Yaseen301/eruca-sync-smart-greenhouse/IMPORT-NOTES.md

# Imported implementation materials

Source: [Nadoooor/Eruca-Sync](https://github.com/Nadoooor/Eruca-Sync)

Pinned source revision: `49f52b0db70bf52fc38d7b9a41fe47a303049562`.

Original implementation author and copyright holder: Nader Sayed. The imported materials retain the upstream [MIT license](LICENSE) and [third-party asset credits](Docs/Credits.md).

## Scope

All 94 files from the pinned source revision are included. The upstream root README is preserved as [README-UPSTREAM.md](README-UPSTREAM.md), so the existing research overview remains the main README. Original relative paths are retained for the other source files, including archival documents and fabrication backups.

The import includes PlatformIO firmware source and configuration, compiled firmware binaries, editable STEP models, KiCad projects and footprints, fabrication outputs, bills of materials, build photos, and documentation.

Existing portfolio, poster, and extracted prototype illustrations are retained. Their authorship remains with the team credited in those documents; importing an MIT-licensed implementation does not by itself relicense those separate research materials.

## Verification and use

Imported file contents are checked against their upstream Git blob hashes. The imported source code and prebuilt binaries have not been modified, rebuilt, flashed, or tested on hardware during this import. The additional [firmware guide](Firmware/README.md) explains where the source, configuration, and prebuilt artifacts are located.
