Yaseen301/eruca-sync-smart-greenhouse/poster-fullsize.pdf

thermoelectric cooler, 1 water pump, and 6 LED sticks, to stabilize the system’s environmental parameters according to specific conditions and ranges.

Egypt faces major drawbacks that negatively affect its way to development. One of these drawbacks is climate change which refers to the vast changes in the average temperature per year. As a result, it impacts decreasing of the industrial and technological bases, leading to a deviation in Egyptian crop production. The purpose of this study is to solve the problem of the increasing threats of climate change to Siwa's crop production. To achieve that, a greenhouse project was chosen, depending on smart feedback loop system that uses temperature, soil moisture and light sensors in addition to actuators. Particularly, the structure is a gabled greenhouse where the plants must be planted and actuators are used. Moreover, the prototype had to meet some design requirements such as the parameter stabilizing time must be less than 30 min and the ability to operate within a time of at least 6 hours in addition to its ability to operate in equal time intervals for 5 consecutive days with a planting area of less than 0.25 m²
. The prototype was judged to be successful, and it met all design requirements as it took maximum 27.5 min to stabilize the parameters values, it was able to operate within 6 hours and in equal time intervals for 5 consecutive days. In addition, it had a planting area of 0.11 m²

Table X: Impact of temperature on crop yield (Moghazy & Kaluarachchi, 2021)

Egypt | faces | major | challenges | that | hinder | its
development and affects its individuals in several fields, involving industry, agriculture, and even its climate. Climate change is one of them that refers to the vast changes in the average temperature per year. Hence, it affected the industrial
and agricultural bases, naming it as another grand challenge.
Consequently, crop production of Egypt has diminished due to
heat stress and deviations in rainfall patterns that can negatively impact crop yields, particularly for heat-sensitive crops leafy greens (Abd El Maksoud, 2022). As shown in table 1, a small increase in temperature, like 2°C and 4°C, causes large hardy crops like maize losses 14.4% and 24.2% of their yield, respectively. Siwa Oasis is expected to lose its crop productivity due to heat changes. Using climate models, summer temperatures in Siwa are expected to rise by up to 4.65°C. Because of this heat, plants will need 18.2% more water just to stay alive, leading to crop failure (Moghazy & Kaluarachchi, 2021). As a result, the specific problem to be solved is the increasing threats of climate change to Siwa's crop production.
One of the prior solutions for such a problem is Thanet Earth, a massive commercial greenhouse complex conceived in the UK with a weak side of high initial investment. Nevertheless, one of its advantages is that it has vast pest and weather resistance. Another solution is El Bustan aquaponics farm, an aquaponic farm producing high quality plants, though having a weak heat control.
Hence, since the prior solutions had high initial cost and weak control, the selected solution is a low-cost gabled greenhouse with light, moisture and temperature control. Particularly, the prototype consists of a wooden gabled greenhouse structure with a maximum height of 0.45m and 0.55m, 0.45m for width and length respectively, to hold plant growth. Thereby, the structure is implemented to a smart closed loop system that associates all electric components with the ESP32 Microcontroller. Furthermore, temperature, soil moisture, light sensors and actuators were employed within the prototype to maintain the environmental conditions for plants to grow. Therefore, the project must meet some requirements to emphasize its successful working. They include its maximum time to stabilize a parameter reading that must not exceed 30 minutes. In addition, it must be able to operate within a time of at least 6 hours, as well as its ability to operate at equal time intervals for 5 consecutive days. Furthermore, the planting area must not exceed 0.25 m2. Finally, it is required to maintain the databases for two plants in the project. Several materials with different properties were used to meet the past requirements and achieve the success of the project, as shown in the next section.

Materials

Figure 14: Circuit’s schematic diagram

Feedback and automation system:
To achieve the best results, as shown in the results section, a feedback and automation system had to be made. As shown in Figure 14, the brain of the system that handles all the logic, sensor data processing, and control signals for the actuators is an ESP32-S3. It is connected to multiple sensors, which are a BH1750 digital light intensity sensor, an AM-2320 temperature sensor, and a capacitive analog soil moisture sensor V2.0, that sends environmental data via I2C or analog signals. Figure 15 shows the code that processes the data by converting the raw sensor outputs to the calibrated values according to the calibration equations using the ESP. After processing the data, the ESP sends orders to multiple connected actuators: 2 fans, 2 servo motors, 1

Table 2, Materials of the prototype

Figure 8: Attaching the servo motors Figure 9: Feedback system's circuit holders

Figure 6: Making the drainage holes

:Figure 7: Filling the planting area with soil mixture

Figure 5: Constructing the outer frame

Figure 4: Calibration Curve of the Temperature Sensor

Figure 3: Calibration Curve of Light Intensity Sensor

Figure 2: Calibration Curve of Soil Moisture Sensor

1-The greenhouse is constructed using recycled components for the main structure. As shown in Table 2, the materials are divided into structural components and the electronic feedback system components.
2-Before constructing, a 3D CAD model of the structure (Figure 1), and a circuit schematic was designed for visualization and mapping the connections.

Methods

Table 3: Sensor Calibration Summary and Error

Figure 1: 3D CAD model
for the prototype

3-The soil moisture, light intensity, and temperature sensors were calibrated against standard reference values, with the calibration process recorded on video. The raw sensor outputs, corresponding reference values, and the quantified error margins are summarized in Table 3.
4- To ensure our greenhouse feedback loop operates with maximum accuracy, all three environmental sensors were calibrated. A simple two-point test was used for the soil moisture sensor (Figure 2), measuring it in dry air for a 0% baseline and then in a full cup of water for a 100% maximum. Defined by the equation
5-The structural frame (Figure 5), including the base, vertical columns, and two roof arcs connected by crossbeams, was assembled using MDF, nails, and recycled furniture wood. A plastic-lined wooden drawer with drilled drainage holes (Figure 6) was centered on the base as the planting bed, and filled with a two-thirds sand and one-third peat moss growing medium (Figure 7).
6-Wooden columns were mounted to hold four servo motors (Figure 8), which control PVC pipes wrapped in variable-transmissivity plastic for sunlight regulation. For thermal control, a Peltier plate with a heat sink and fan was housed within the side panels. Finally, a wooden control panel was built for the main circuit (Figure 9), and the water
pump tubing was routed from an external tank to the soil.
Test Plan
1-The planting area should be measured to make sure it doesn’t exceed the required 0.25m²
. Furthermore, the greenhouse prototype ran automatically for a full 6 hours while the live sensor readings were being recorded. During this phase, the specific actuators, the Peltier fans, the water pump, and the sunlight controlling system, were artificially triggered to verify their responsiveness, and the power consumption of each actuator was measured and reported in watts.
2-The system’s feedback control loop was evaluated by introducing three realistic deviations from normal conditions for the selected three parameters: Temperature, light, and moisture. Moreover, the time required for the control algorithm to restore system stability and its maximum was recorded. In addition, while the prototype was placed outdoors, the data logging was conducted four times daily at fixed intervals for five consecutive days and then the average of three readings were recorded. 3- A preloaded database for containing environmental condition ranges for arugula and spinach was set up in the software of the prototype. The testing involved switching the active profile to verify that there is no deficiency in the data or updates.

Negative results:
1) Two servo motors were permanently damaged due to a wiring error. Accidentally swapping the Ground (GND) and Power (VCC) jumper wires led to an immediate short circuit and thermal overload that destroyed the motors.
2) The horizontal crossbeams connecting the upper roof arcs snapped completely during assembly. They were cut too thin, which lacked the necessary strength to withstand the weight applied when mounting the PVC curtain mechanism.
3) The soil moisture sensor returned negative percentage readings when exposed to ambient dry air, despite being calibrated to a 0% baseline. To resolve this hardware issue, a software adjustment was integrated into the microcontroller's logic, ensuring that any calculated value dropping below zero was automatically constrained to exactly 0%.

Positive results:

1-Table 4 confirmed the feedback loop's efficiency,
successfully restoring system stability with maximum recovery times of 1,650 seconds for temperature shifts, 45 seconds for light changes, and 12 seconds for soil moisture deviations.
2-Figure 10 shows that the system successfully maintained stability across all three parameters during continuous operation.
3- As shown in table 5, the power total power consumption of the actuators was around 41 w.
4) As shown in Figures 11, 12, and 13, and table Y, the prototype's consistency over five consecutive days. Accurately tracking distinct cycles at 6:00 AM, 2:00 PM, and

10:00 PM. Table 4: Time to restore system stability

Figure 10: Temperature, Soil Moisture, and Light Intensity readings over 6 hours

Table 5: Time to restore system stability

Table 6, response time across 5 days

Figure 11: Average Soil Moisture over equal time intervals on five consecutive days

Figure 13: Average Temperature over equal time intervals on five consecutive days

Figure 12: Average Light Intensity over equal time intervals on five consecutive days several MOSFETs were used, which can control the flow of electricity through the actuators. In addition, the microcontroller is connected to a TFT touch screen that represents the live sensor readings and their graphs, and it can be used to switch between the environmental condition ranges according to the selected plant species.

thermoelectric cooler, 1 water pump, and 6 LED sticks, to stabilize the system’s environmental parameters according to specific conditions and ranges. To manage the power getting to the actuators from the power supply,

Figure 15: Mathematical calibration code

It is essential to keep the soil moisture within a suitable range for the
growth of he arugula and spinach plants. For the arugula plant, soil moisture of approximately 58% to 62% is considered a suitable range (Lee et al., 2024). For the spinach plant, soil moisture of approximately 65% to 75% is considered a suitable range (Sun et al., 2023). To ensure that the system takes the least amount of time to irrigate the plants and reach the optimal soil moisture percentage, the expected optimal time of irrigation should be calculated. This will help prevent unexpected errors, such as over-irrigation, and check whether the irrigation time meets the design requirements.

Expected Optimal Time of Irrigation:

Equation 1: Required Volume of Irrigation Water
First, to get the time of irrigation, the required volume of irrigation water should be calculated. As shown in Equation 1, Vw is the volume of irrigation water, ΔFC% is the difference between the current percentage of water in the soil’s field capacity and the target percentage, FC%total
is the standard total field capacity for sandy loam soil, which means the percentage of empty spaces in the soil that can hold water, which is equal to 20% in the case of sandy loam (Cornell University, 2010), and Vs
is the volume of the soil. In the worst case of irrigating the plants, the current percentage of water in the field capacity would be 50%. So, to make it reach 60% for arugula and 70% for spinach, the difference in percentages is 10% and 20%. By substituting in Equation X, the volumes of water needed to irrigate the arugula and spinach plants are approximately 151.22 ml and 302.44 ml, respectively.

Equation 2: Time of Irrigation
Equation 2 is used to calculate the time of irrigation (t) using the required water volume (Vw) and the volume flow rate of the water pump (Q), which is equal to 1333 ml/min. In the worst case. By substitution, the expected time required for the arugula and spinach irrigation is 6.8 sec. and 13.61 sec. respectively. An additional 5 sec can be added due to the time of water flow through the hose to reach the openings.
Light intensity calculations & actuating:
With its various units, light intensity parameter is a main factor that affects plant growth because of its major role in photosynthesis process. The units of light intensity are divided into 3 main types, photometric, radiometric, and quantum units. Firstly, the measurement unit of the used sensor, photometric unit, is lux unit which is equivalent to one lumen per square meter. Another type is radiometric unit, energy per unit time and unit area (W/m²
). Quantum unit can be measured with µmol . s

-1

. m⁻²
, which is based on the number of photons in a certain wave band incident per unit time (s) on a unit area (m2) divided by the Avogadro constant. The needed light intensity for arugula plant to grow is 185:200 µmol . s

-1

. m⁻²
. Then, as the sensor uses lux unit, the value must be converted according to equation 3 by multiplying by the conversion factor of sun light, which is 54 (Thimijan & Heins, 1983), where L is light intensity measured with photometric and quantum units. As a result, 9990: 11610 lx is the resulting light intensity needed.

Equation 3, light value with lx. (Thimijan & Heins, 1983)
After finding the light intensity needed with photometric unit, the actuation of light was done by using plastic films with different transmissivities. Transmissivity is the ratio between the light intensity entering the greenhouse and the reached sunlight intensity as shown in equation 4.

Equation 4, transmissivity
Then, plastic films and papers with different shades were exposed to lamp light and the light intensity was measured to get transmissivity values shown in figure 16. Hence, the plastic films can minimize the sunlight intensity throughout the day to reach the needed value, knowing that black films are used to block most of the light when the light intensity over exceeds the needed value (cannot be minimized to reach it), and that is when the LED is turned on. Therefore, the light intensity reaches the plant is at the optimum value and provides virtuous conditions for crop growth in addition to preserved energy consumption

Figure 16, transmissivity for several plastic films and papers
Geometric shape analysis:
To preserve the consumption of energy in the project, geometric shape plays a major role in minimizing the range of light intensity needed to actuate and then the energy consumption of motors and lamps. Thus, the average solar radiation in the region of Siwa is for one day is 6.3 kWh/m²
/ day (Atia et al., 2023). Hence, dividing by 24 hours, the average sunlight irradiance is 0.2625 Kw/ m²
. Since the light intensity needed for the arugula plant is measured by µmol . s

-1

. m⁻²
, the unit must be converted according to equation 5 by multiplying with the conversion coefficient of daylight (where L Quantum is the light intensity measured by µmol . s

-1

. m⁻²
,

and L Radiometric

is the light intensity measured in W/m² ).

Figure 17, transmissivity for several greenhouses’ geometric shape (Valera Martínez et al., 2016).

After finding the suitable shape, the next step was finding the average light intensity entering the greenhouse during the year. As shown in figure 17, the transmissivity of the greenhouse with the selected structure averages between 0.35 (winter through north-south direction) and 0.57 (summer through north-south direction). Therefore, substituting in equation 4 (the previous analysis point), the resulted average light intensity entering the greenhouse ranges between 420 and 660 µmol . s

-1

. m⁻²

Equation 5, Light value with µmol . s

-1

. m-

Climate change poses a severe threat to Egypt's agricultural development, specifically causing deviations in crop production in regions like Siwa. Eruca sync successfully addressed this challenge, proving that a smart, closed-loop feedback system can actively protect crops from environmental shifts. Results demonstrated that the prototype met all specific design requirements. The system proved its reliability by operating automatically for a full 6 hours and successfully logging data at equal time intervals over 5 consecutive days outdoors. Furthermore, when parameters changed, the temperature, soil moisture, and light sensors efficiently triggered the actuators to restore optimal conditions. System stability was fully achieved in just 27.5 minutes maximum, beating the required 30-minute maximum. Compared to traditional farming, which leaves crops entirely exposed to climate variations, Eruca Sync significantly minimizes crop loss. By continuously adapting to the environment without human intervention, this prototype offers to increase Egypt's agricultural base.

Raspberry Pi Zero SBC:

Table 7: Learning outcomes used

It is recommended to apply this project to the Siwa region, which is a natural depression with an area of 0.28 million acres located in the northwest of the Western Desert in Egypt, as shown in Figure 18. Egypt’s proposed development project in Siwa is to reclaim 30,000 acres. However, Siwa’s crop production is threatened due to global climate change. A study investigated whether government goals are possible under climate change during this century using different climate models under two representative concentration pathways (RCPs): RCP 4.5 and RCP 8.5. Using these models, summer temperatures in Siwa are expected to rise by up to 4.65 °C, which means that plants will need 18.2% more water just to stay alive. Hardy crops like maize losses 14.4% and 24.2% of their yield due to a small increase in

Figure 18: Reclamation Areas in the Siwa Oasis Region.
temperature, such as 2 °C and 4 °C (Moghazy & Kaluarachchi, 2021). This means that tiny leafy greens, like arugula and spinach, would likely face 100% crop failure if planted in the same conditions. That’s why this location is perfect for confronting the increasing threats of climate change to Siwa’s crop production.

For the materials of the real-life project, the real-life project should mostly be composed of the same materials as the prototype, except for the plastic sheets covering the greenhouse, which could be replaced with isolating glass pieces. The electronic components don’t have to be recycled. The ratio between the dimensions of the prototype to that of the real-life project will be 2.00387:100 to make 1,000 greenhouses across the reclamation area of the Siwa region. The real-life project’s dimensions will be the same as the prototype, but with consideration of the scale conversion. The real-life project should have the ability to operate for multiple days without burning out.

For the materials of the real-life project, the real-life project should mostly be
composed of the same materials as the prototype, except for the plastic sheets covering the greenhouse, which could be replaced with isolating glass pieces. The electronic components don’t have to be recycled. The ratio between the dimensions of the prototype to that of the real-life project will be 2.00387:100 to make 1,000 greenhouses across the reclamation area of the Siwa region. The real-real-life project’s dimensions

Real life application:

Figure 19: Raspberry Pi Zero
will be the same as the prototype, but with consideration of the scale conversion. The real-life project should have the ability to operate for multiple days without burning out.

To improve the prototype’s automation and prepare it for larger farms, expanding the system's hardware capacity is a necessity. Currently, the greenhouse relies on a user manually switching the system between day and night profiles. This manual step is necessary because the ESP microcontroller does not have enough pins to run all the physical actuators while keeping the Wi-Fi connection active. To solve this problem, we highly recommend integrating a shift register into the main circuit. A shift register is a highly effective component that uses only a few pins from the microcontroller to create multiple new output pins. By adding this chip, the water pump, Peltier module, and all servo motors can be easily controlled while keeping the necessary pins free for the Wi-Fi module.
Once the hardware is upgraded with a shift register and Wi-Fi is safely connected, the system can be fully automated. The greenhouse will be able to connect to the internet and automatically sync its day and night cycles with the actual sunrise and sunset times. Finally, this internet connection will allow developers to build a smart web dashboard, letting farmers remotely monitor temperature, moisture, and light levels from anywhere, making this prototype a scalable solution for modern agriculture.

Shift Register Integration for Full Automation:

1- Cornell University. (2010). PO 12.1-3 field capacity, permanent wilting point & available water capacity.
Northeast Region | CertifieCrop | Adviser | Study | Resources.
https://nrcca.cals.cornell.edu/soil/CA2/CA0212.1-3.php
2- Lee, K., An, S. K., Ku, K.-M., & Kim, J. (2024). The optimum substrate moisture level to enhance the growth
and quality | of | arugula | (Eruca | sativa). | Horticulturae, | 10(5), | 483.
https://doi.org/10.3390/horticulturae10050483
3- Moghazy, N. H., & Kaluarachchi, J. J. (2021). Impact of climate change on agricultural development in a closed groundwater-driven basin: A case study of the Siwa region, Western Desert of Egypt. Sustainability, 13(3), 1578. https://doi.org/10.3390/su13031578
4- Sun, Y., Wang, J., Wang, Q., & Wang, C. (2023). Responses of the growth characteristics of spinach to d ifferent moisture contents in soil under irrigationwith magnetoelectric water. Agronomy, 13(3), 657.https://doi.org/10.3390/agronomy13030657
5-Thimijan, R. W., & Heins, R. D. (1983). Photometric, radiometric, and quantum light units of measure: A review of procedures for interconversion. HortScience, 18(6), 818–822.

Thanks and gratitude go to the capstone general, Mohamed Bekheet, the capstone leader, Ninette Refaat, and the capstone teacher, Mona, for their huge contributions to the production process of this work. Without their efforts, this project wouldn’t have been presented and produced in this way that satisfies the Capstone requirements and constraints.
