Yaseen301/eruca-sync-smart-greenhouse/Photos/3d PCB.png

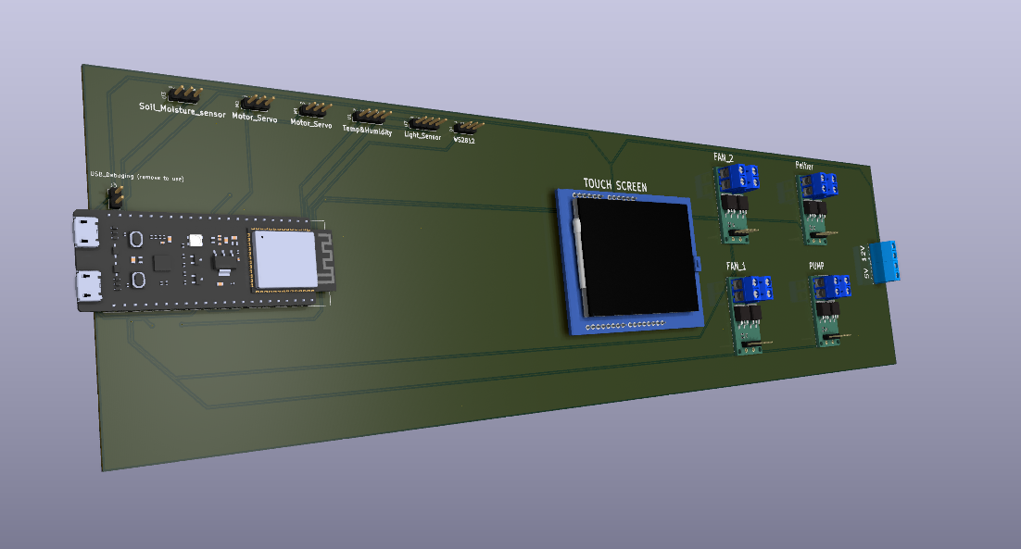
Photos/3d PCB.png
