Yaseen301/eruca-sync-smart-greenhouse/Photos/COOL.png

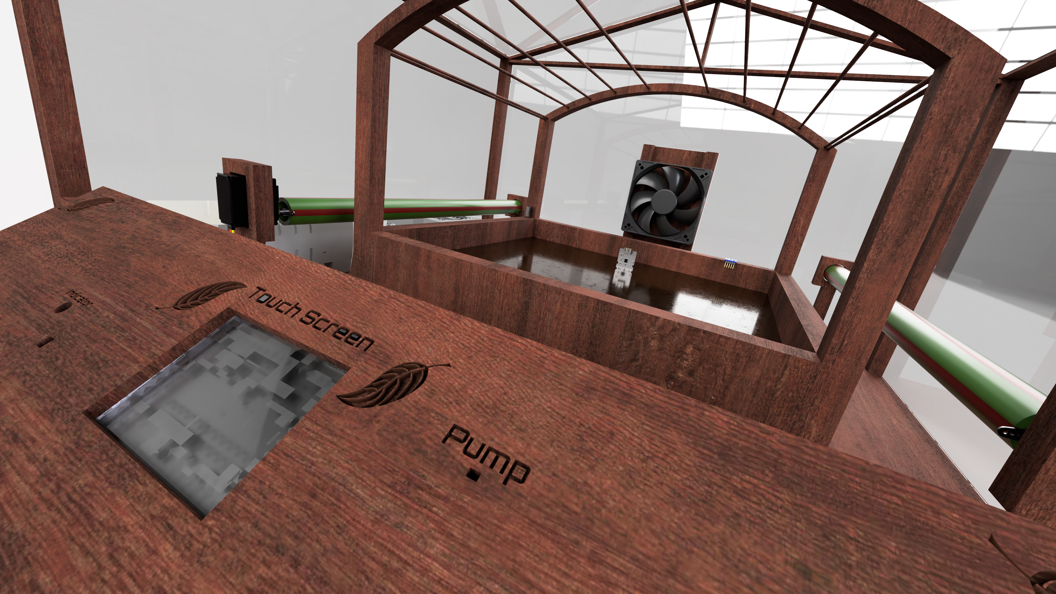
Photos/COOL.png
