Yaseen301/eruca-sync-smart-greenhouse/Photos/Erucazine.png

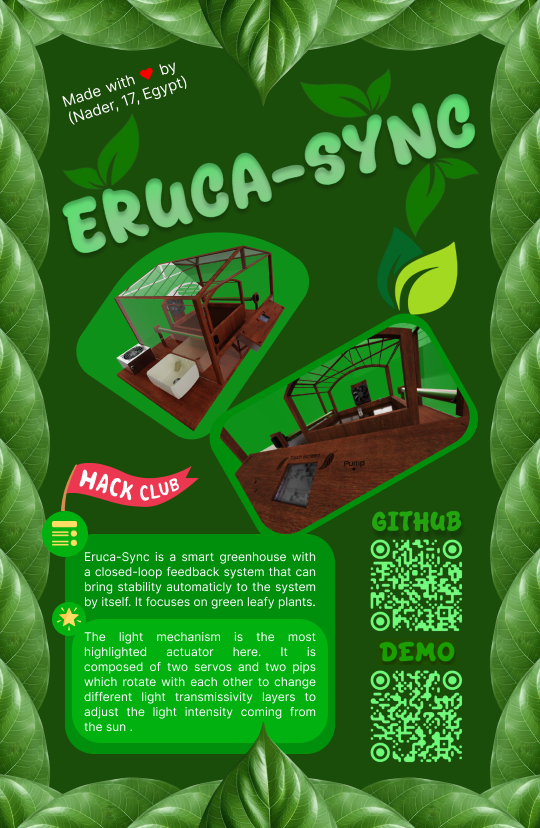
Photos/Erucazine.png
