Yaseen301/eruca-sync-smart-greenhouse/Photos/FINAL-f.png

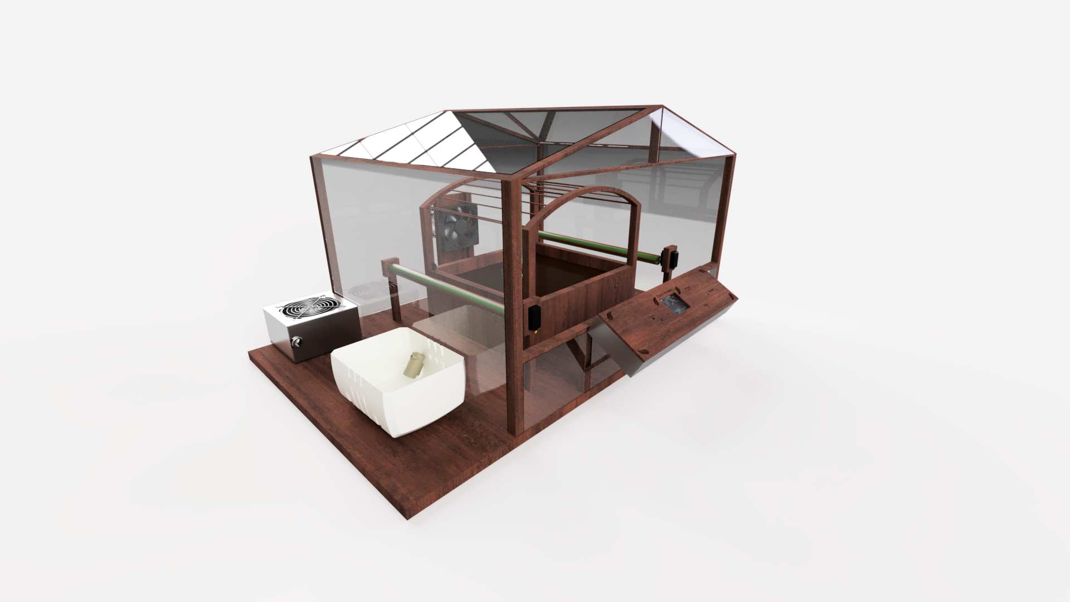
Photos/FINAL-f.png
