Yaseen301/eruca-sync-smart-greenhouse/Photos/FINAL_b.png

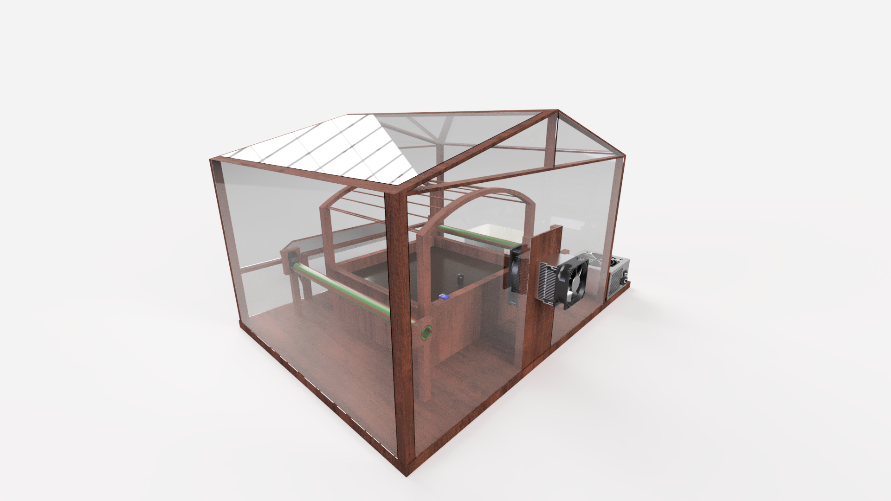
Photos/FINAL_b.png
