Yaseen301/eruca-sync-smart-greenhouse/Photos/FINAL_fPC.png

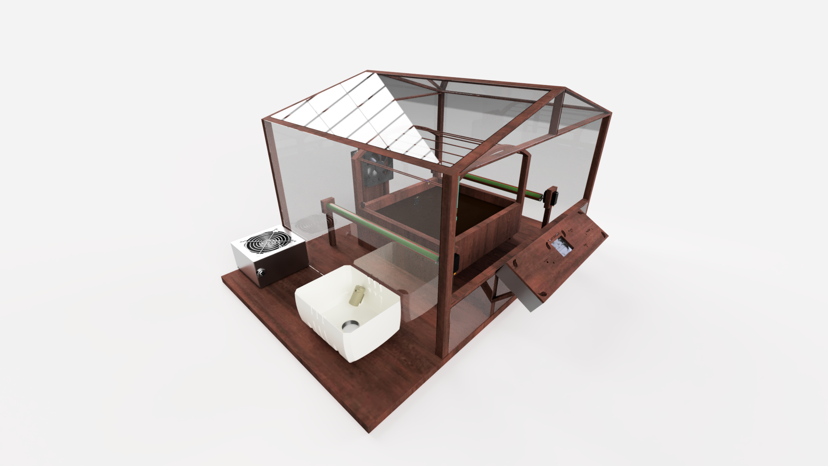
Photos/FINAL_fPC.png
