Yaseen301/eruca-sync-smart-greenhouse/Photos/Hope.png

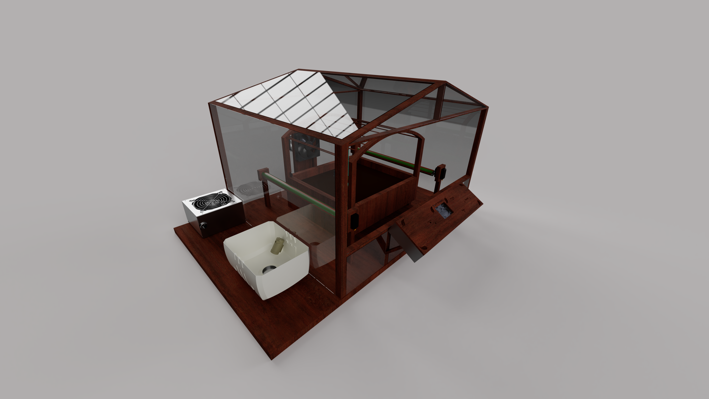
Photos/Hope.png
