Yaseen301/eruca-sync-smart-greenhouse/Photos/leaf2.png

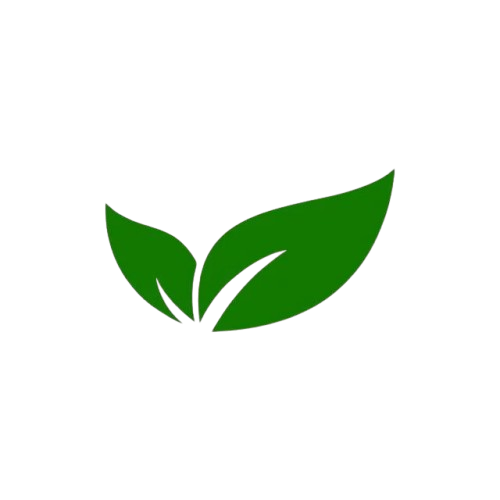
Photos/leaf2.png
