Yaseen301/eruca-sync-smart-greenhouse/Photos/leaf3.png

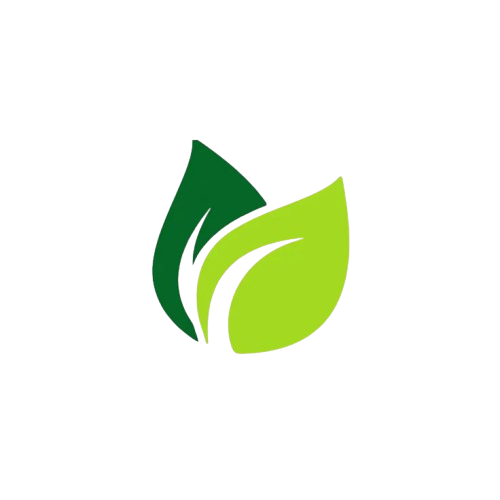
Photos/leaf3.png
