Yaseen301/eruca-sync-smart-greenhouse/Photos/leaf.png

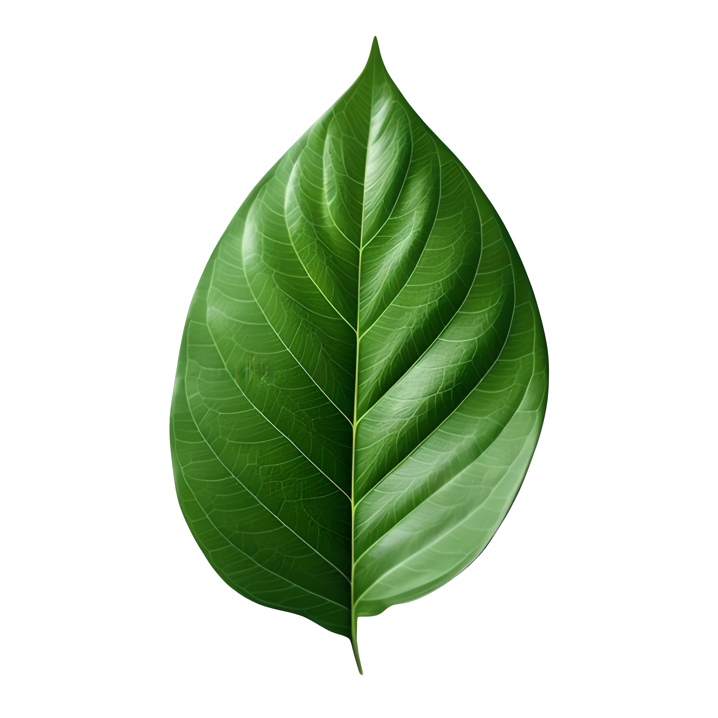
Photos/leaf.png
