Yaseen301/eruca-sync-smart-greenhouse/Photos/PCB.png

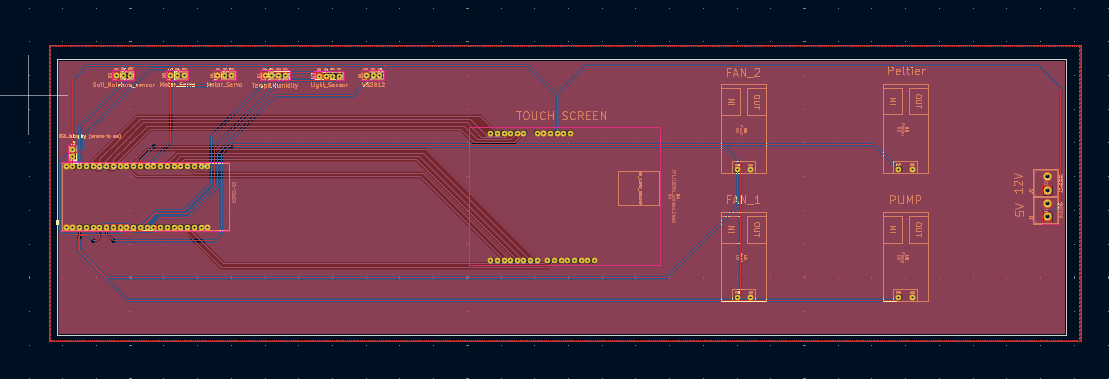
Photos/PCB.png
