Yaseen301/eruca-sync-smart-greenhouse/Photos/Schematic.png

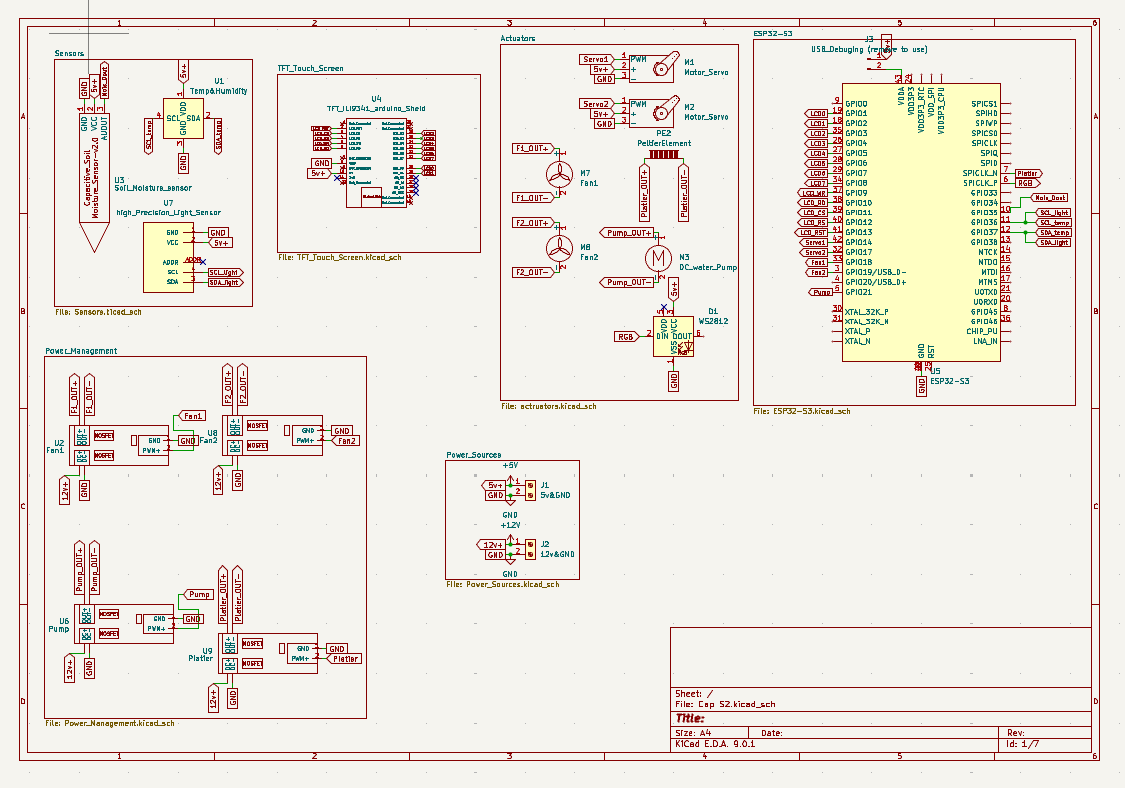
Photos/Schematic.png
