Yaseen301/eruca-sync-smart-greenhouse/Photos/star.png

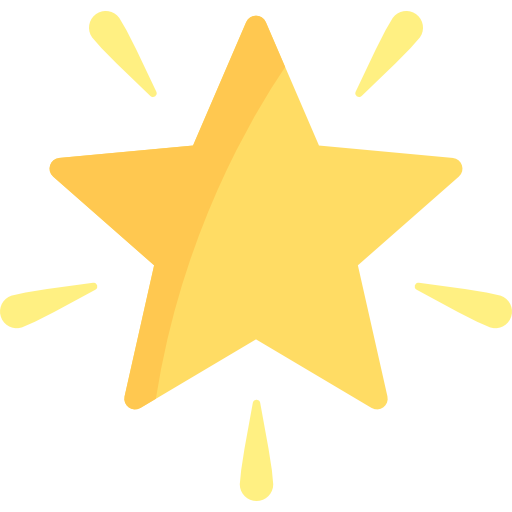
Photos/star.png
