Yaseen301/eruca-sync-smart-greenhouse/BOM.csv

Item Name | purchase links | Quantity | Price Per Unit | Total
FS5106R Servo Motor 360° Continuous 6 kg.cm Plastic Gears | https://www.ram-e-shop.com/shop/servo-fs5106r-fs5106r-servo-motor-360deg-continuous-6-kg-cm-plastic-gears-7122 | 2 | $7.4 | $14.8
AM-2320 Temperature & Humidity Calibrated Sensor | https://www.ram-e-shop.com/shop/sen-am2320-am-2320-temperature-humidity-calibrated-sensor-asair-r-original-brand-7776 | 1 | $3.28 | $3.28
NeoPixel Stick 8-bit WS2812 5050 RGB LED | https://www.ram-e-shop.com/shop/kit-ws2812-8-5050-strip-neopixel-stick-8-bit-ws2812-5050-rgb-led-driver-development-board-8257 | 6 | $0.84 | $5.04
Capacitive Analog Soil Moisture Sensor V2.0 | https://www.ram-e-shop.com/shop/sen-soil-c-capacitive-analog-soil-moisture-sensor-v2-0-sku-soil-c-8116 | 1 | $1.87 | $1.87
BH1750 Light Calibrated Sensor | https://ar.aliexpress.com/item/1005009671465215.html?curPageLogUid=4LlmP7toFGiX | 5 | $1.31 | $6.55
Water Pump 3-6Vdc Mini 120L/H | https://www.ram-e-shop.com/shop/dc-pump-6vdc-water-pump-3-6vdc-mini-120l-h-7422 | 1 | $0.84 | $0.84
Thermoelectric Cooler 40x40mm - Peltier | https://www.ram-e-shop.com/shop/sf10080-thermoelectric-cooler-40x40mm-peltier-6726 | 1 | $2.81 | $2.81
Aluminum Heatsink HS.13 Size 40x40x11 mm | https://www.ram-e-shop.com/shop/hs13-aluminum-heatsink-hs-13-size-40x40x11-mm-7713 | 1 | $0.52 | $0.52
Kit MOSFET 15A 400W - Trigger Switch Drive Module | https://www.ram-e-shop.com/shop/kit-mosfet-15a-400w-kit-mosfet-15a-400w-trigger-switch-drive-module-with-pwm-regulator-control-8008 | 5 | $0.84 | $4.22
PC Old Power Supply - 200W | https://www.dubizzle.com.eg/en/electronics-home-appliances/computers-accessories/q-power-supply/ | 1 | $2 | $2
Old PC CPU Cooler with its Fan | https://www.dubizzle.com.eg/en/ad/amd-cpu-stock-fan-ID207435960.html | 1 | $5.62 | $5.62
Old PC Fan 12cm | https://www.dubizzle.com.eg/en/ad/%D9%85%D8%B1%D9%88%D8%A2%D8%A9-%D8%A7%D9%84%D9%83%D9%85%D8%A8%D9%8A%D9%88%D8%AA%D8%B1-pc-case-fan-ID207415788.html | 1 | $1.56 | $1.56
Water Container (Any bottle or box) | https://www.amazon.eg/-/en/elyassin-plastic-food-container-size/dp/B0C4K14QZV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 | 1 | $1.3 | $1.3
Wood with the dimensions (I used recycled wood)(all the dimensions are in the onshape) | https://goodwood.com.eg/en/new-details.php?id=5973 | ~~~ | Vary | Vary
Plastic bags or plastic sheets | https://www.amazon.eg/-/en/Zpac-freezer-bag-heavy-duty/dp/B09T3HLTGR | ~~~ | ~~~ | ~~~
Jumper Wires | https://www.ram-e-shop.com/shop/ph61-mm-20cm-ph61-20cm-male-to-male-40-jumper-wires-set-7094 | 60 | $0.019 | $1.14
LCD TFT 2.8 inch Touch Display with ILI9341 Driver 8bit Parallel | https://www.ram-e-shop.com/shop/kit-lcd-tft-2-8-touch-lcd-tft-2-8-inch-touch-display-for-arduino-uno-mega2560-8003 | 1 | $12.18 | $12.18
ESP32-S3-N16R8 Development Board WIFI and Bluetooth | https://mostelectronic.com/shop/arduino-development-boards/esp32-s3-n16r8-development-board-wifi-and-bluetooth/ | 1 | $14.06 | $14.06
PVC pipes as the rotation axies | https://hegazy-group.com/products/engineering-home-pvc-elecetrical-pipe-25mm-3-meter | 2 x 0.5 meter | $3 | $6
Some Nails | https://www.amazon.eg/-/en/1-2mm-Plain-Steel-Joinery-Nails/dp/B09CDNXTX5?mcid=a3513e1143233c7d97289a4cd67e9979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 | 30 | $0.027 | $0.8
MDF Fast Adhesive Glue | https://www.amazon.eg/-/en/Akfix-705-Universal-Fast-Adhesive/dp/B07MCQWCQV | 2 | $3.18 | $6.36
PCB | https://uge-one.com/pcb-print-design/ | 1 | $20 | $20
Shipping | ~~~~~~~~~~ | ~~~ | ~~~ | $6.74
Total | ~~~~~~~~~~ | ~~~ | ~~~ | $117.69
