Yaseen301/eruca-sync-smart-greenhouse/PCB/PCB_3D.step

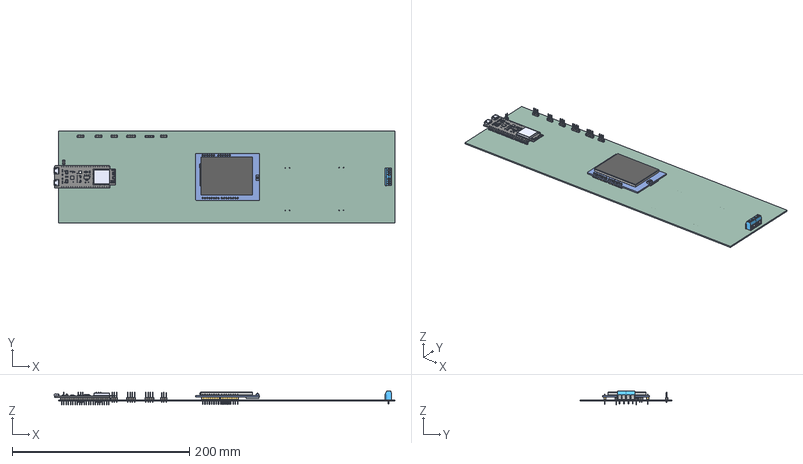
[picture p85: CAD file, 2026-10-24]
PCB/PCB_3D.step
385.3 x 103.7 x 16.0 mm
Tornillos001 x 2
PinHeader_1x04_P2.54mm_Vertical x 2
2.4INCH_TFT_DISPLAY_SHIELD_FOR_ARDUINO x 36
PIN_HEADER_MALE_2.54MM_PITCH_8 WAY_1 x 16
PIN_HEADER_MALE_2.54MM_PITCH_8 WAY x 16
PIN_HEADER_MALE_2.54MM_PITCH_6 WAY x 12
PIN_HEADER_MALE_2.54MM_PITCH_6 WAY_1 x 12
PinHeader_1x03_P2.54mm_Vertical x 4
PinHeader_1x02_P2.54mm_Vertical
ESP32-S3-DEVKITC-1-N8R8
Cap S2_PCB
