Yaseen301/eruca-sync-smart-greenhouse/(list of files, cad)

Other CAD files:
3D design/3D.step
Production/3D design/3D.step
