Yaseen301/eruca-sync-smart-greenhouse/Docs/Build-photos/column_nail_head_mod.png

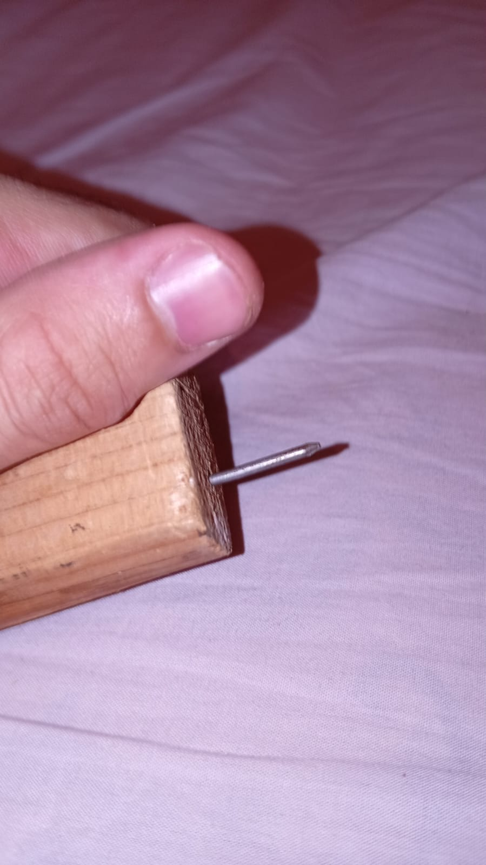
Docs/Build-photos/column_nail_head_mod.png
