Yaseen301/eruca-sync-smart-greenhouse/Docs/Build-photos/connecting circuit for the first time.jpg

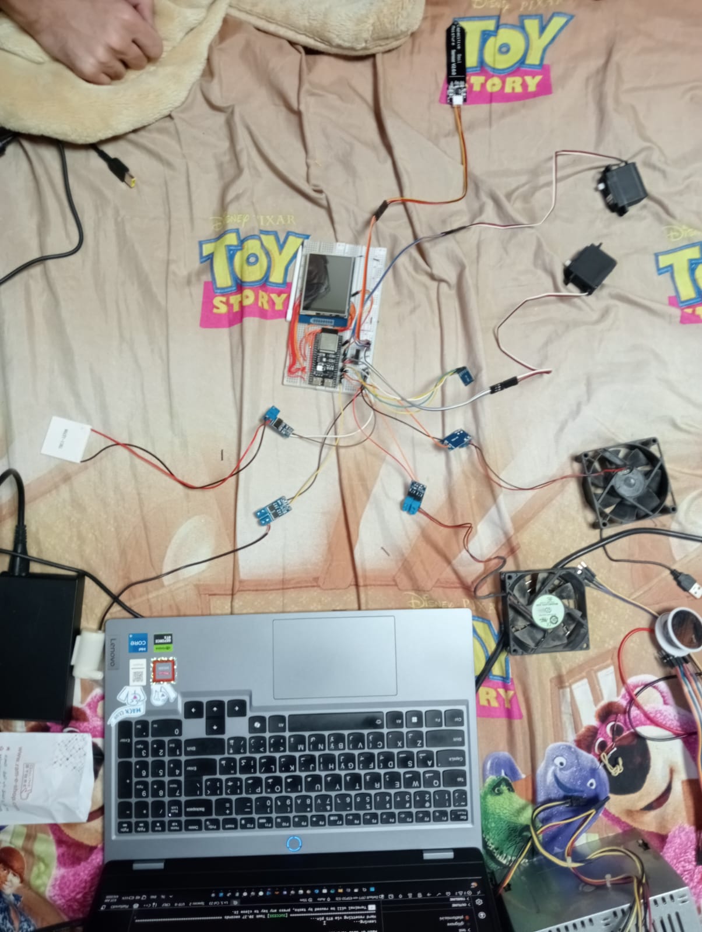
Docs/Build-photos/connecting circuit for the first time.jpg
