Yaseen301/eruca-sync-smart-greenhouse/Docs/Build-photos/connecting the circuit in the structure.jpg

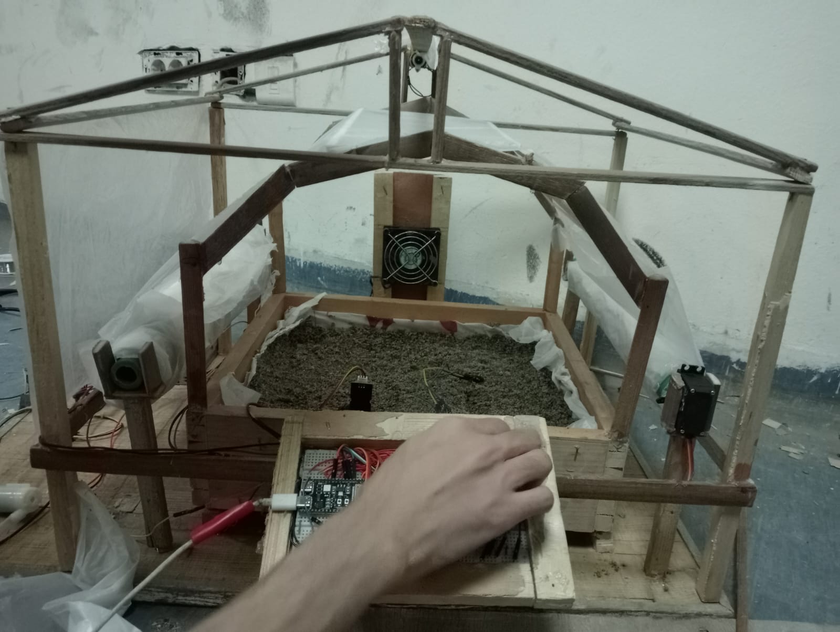
Docs/Build-photos/connecting the circuit in the structure.jpg
