Yaseen301/eruca-sync-smart-greenhouse/Docs/Build-photos/connecting wooden pieces with MDF.jpg

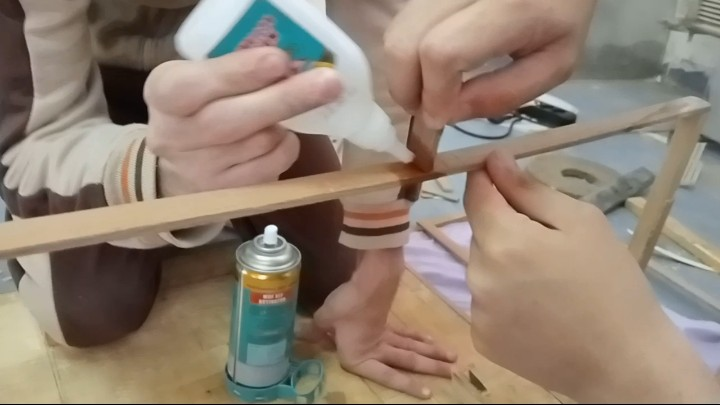
Docs/Build-photos/connecting wooden pieces with MDF.jpg
