Yaseen301/eruca-sync-smart-greenhouse/Docs/Build-photos/control_panel_screen_active.png

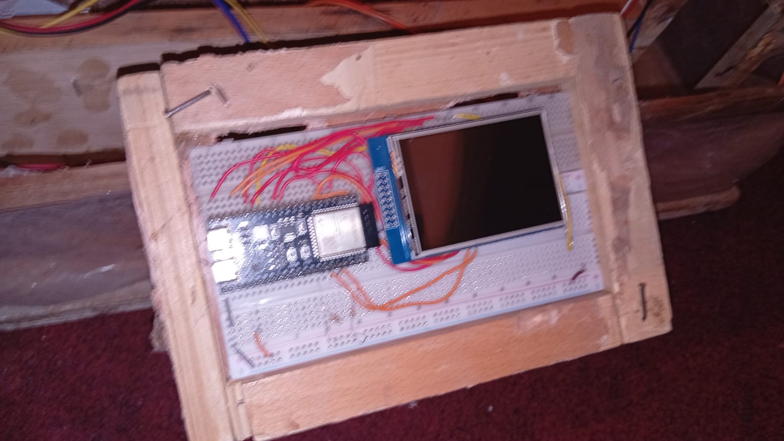
Docs/Build-photos/control_panel_screen_active.png
