Yaseen301/eruca-sync-smart-greenhouse/Docs/Build-photos/cutting plastic sheet.jpg

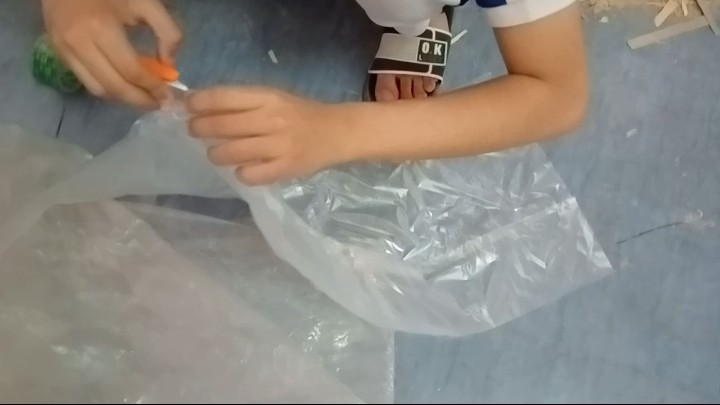
Docs/Build-photos/cutting plastic sheet.jpg
