Yaseen301/eruca-sync-smart-greenhouse/Docs/Build-photos/desk_top_base.png

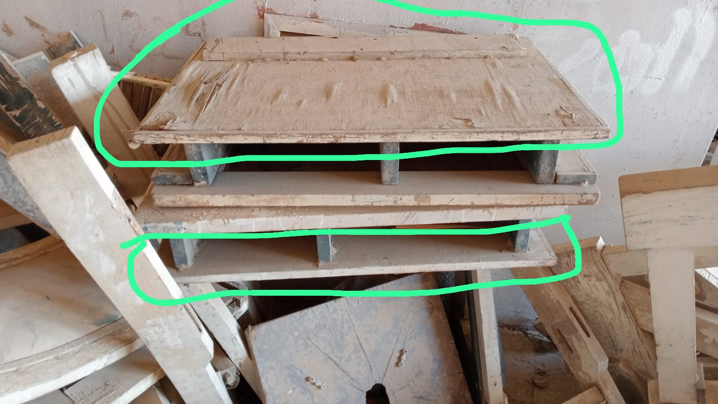
Docs/Build-photos/desk_top_base.png
