Yaseen301/eruca-sync-smart-greenhouse/Docs/Build-photos/dismantling_drawers.png

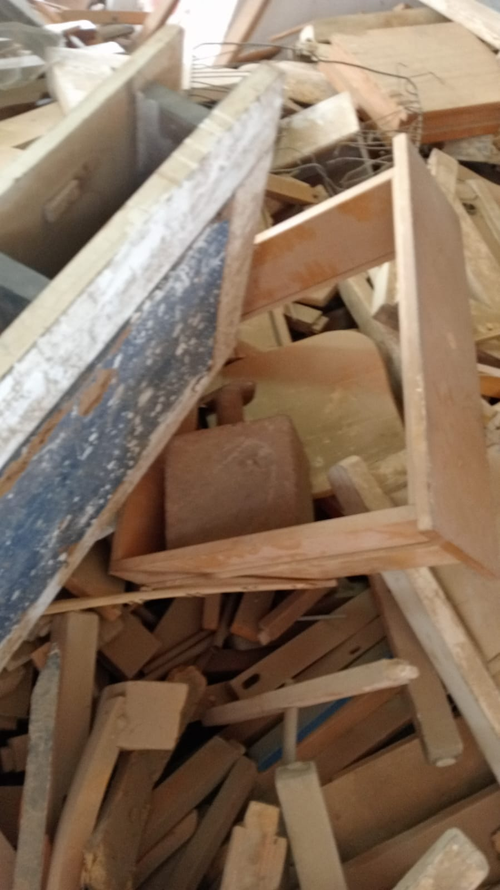
Docs/Build-photos/dismantling_drawers.png
