Yaseen301/eruca-sync-smart-greenhouse/Docs/Build-photos/drawer_elevation_blocks.png

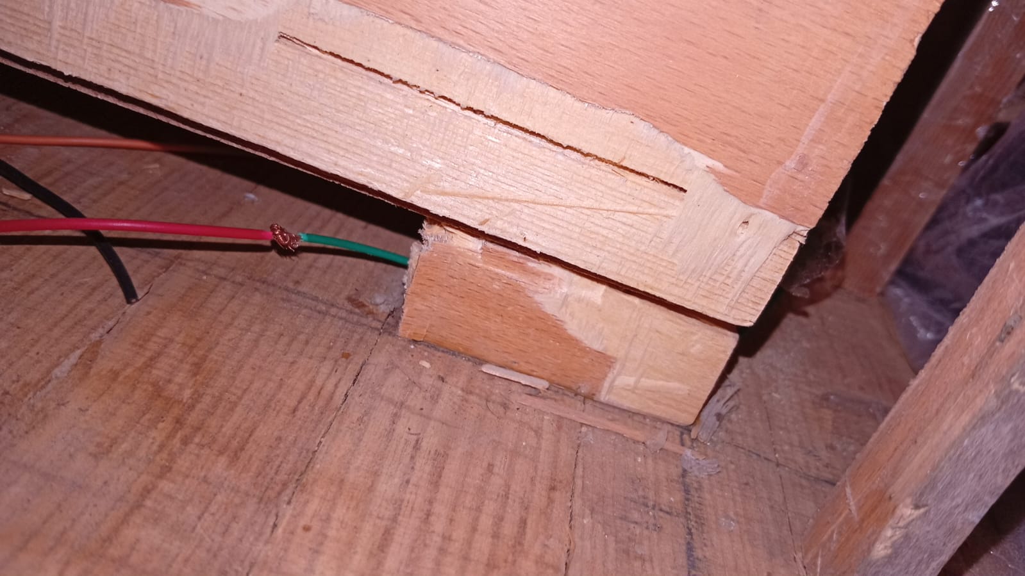
Docs/Build-photos/drawer_elevation_blocks.png
