Yaseen301/eruca-sync-smart-greenhouse/Docs/Build-photos/dried sand.jpg

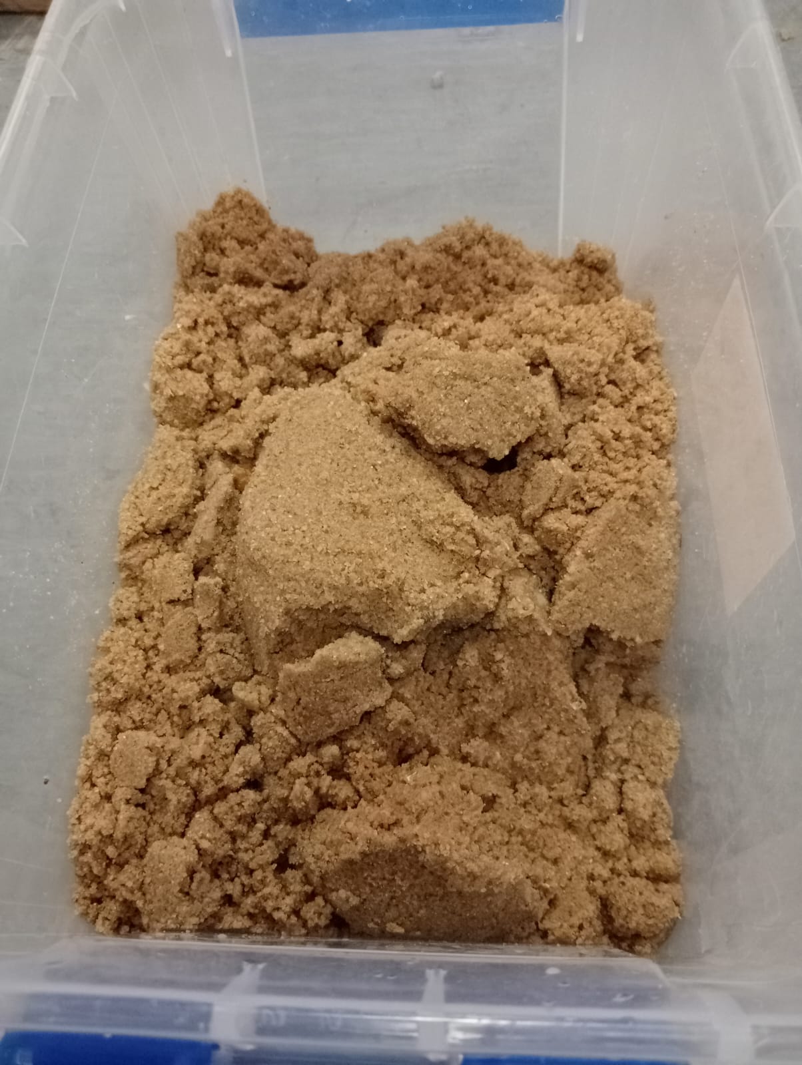
Docs/Build-photos/dried sand.jpg
