Yaseen301/eruca-sync-smart-greenhouse/Docs/Build-photos/dual_breadboard_circuit.png

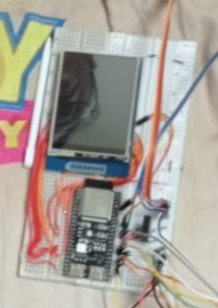
Docs/Build-photos/dual_breadboard_circuit.png
