Yaseen301/eruca-sync-smart-greenhouse/Docs/Build-photos/filling the planting box with soil.jpg

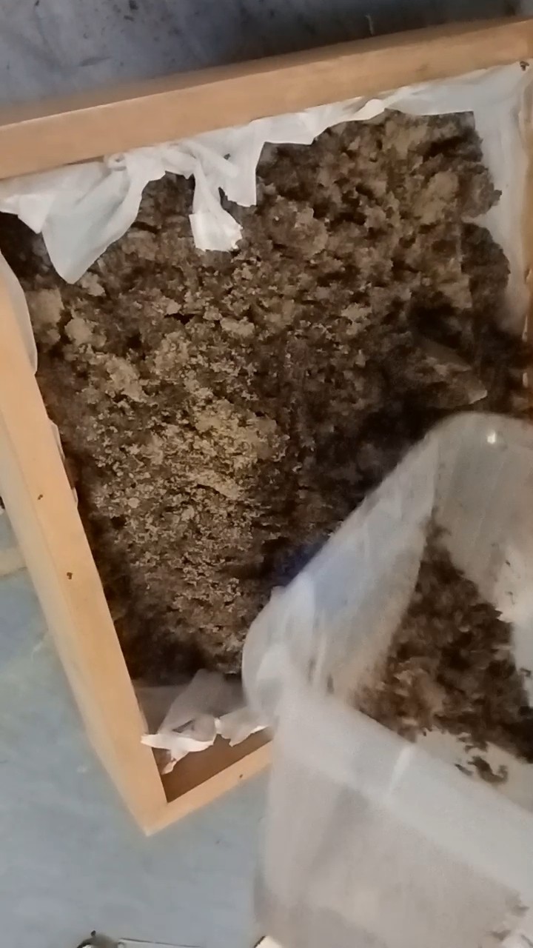
Docs/Build-photos/filling the planting box with soil.jpg
