Yaseen301/eruca-sync-smart-greenhouse/Docs/Build-photos/final look with arugula seedlings.jpg

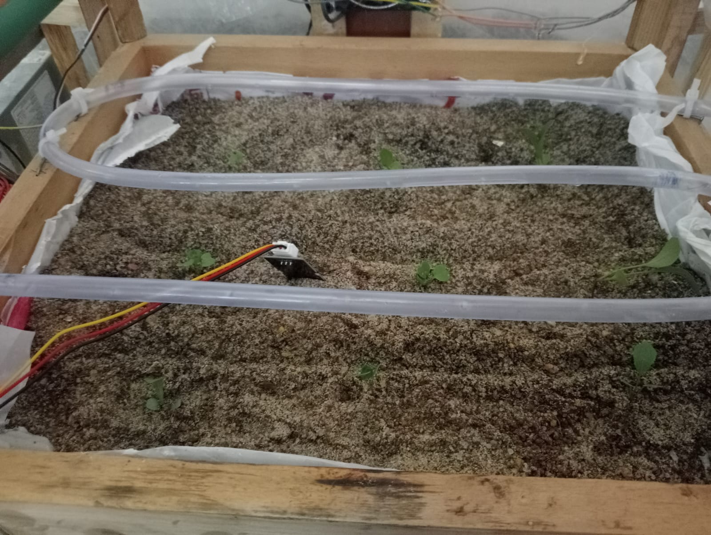
Docs/Build-photos/final look with arugula seedlings.jpg
