Yaseen301/eruca-sync-smart-greenhouse/Docs/Build-photos/final_greenhouse_prototype.png

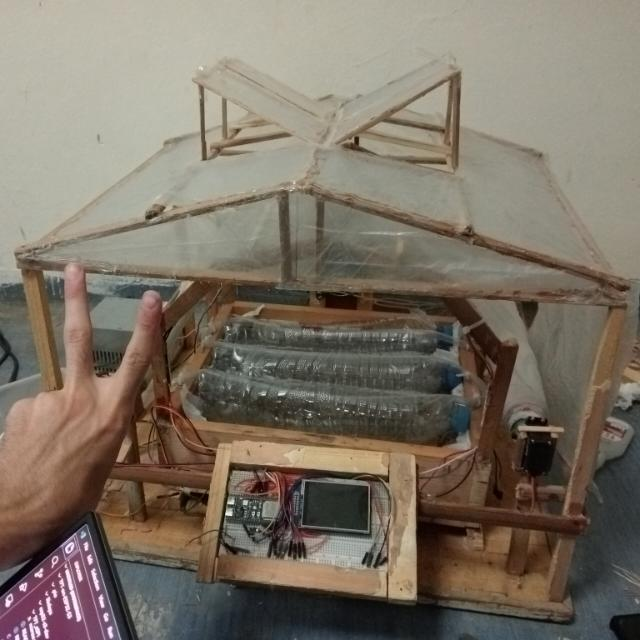
Docs/Build-photos/final_greenhouse_prototype.png
