Yaseen301/eruca-sync-smart-greenhouse/Docs/Build-photos/gluing_greenhouse_sheets.png

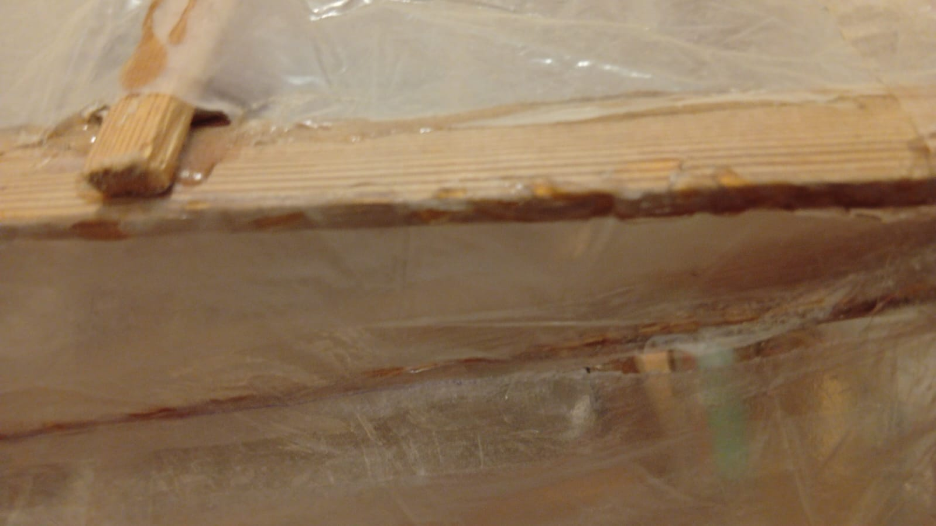
Docs/Build-photos/gluing_greenhouse_sheets.png
