Yaseen301/eruca-sync-smart-greenhouse/Docs/Build-photos/marking the holes on the plastic tube.jpg

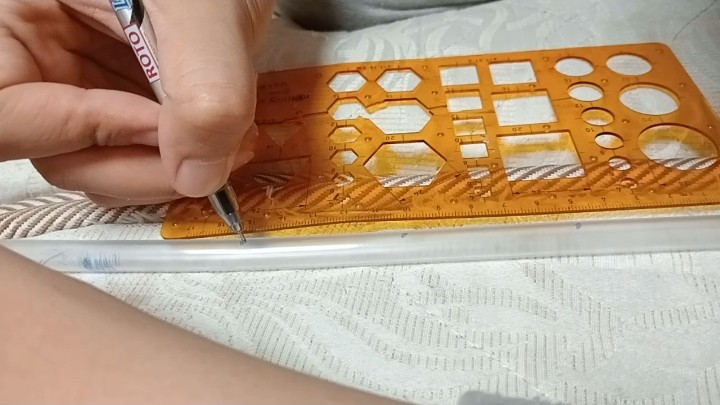
Docs/Build-photos/marking the holes on the plastic tube.jpg
