Yaseen301/eruca-sync-smart-greenhouse/Docs/Build-photos/measuring length.jpg

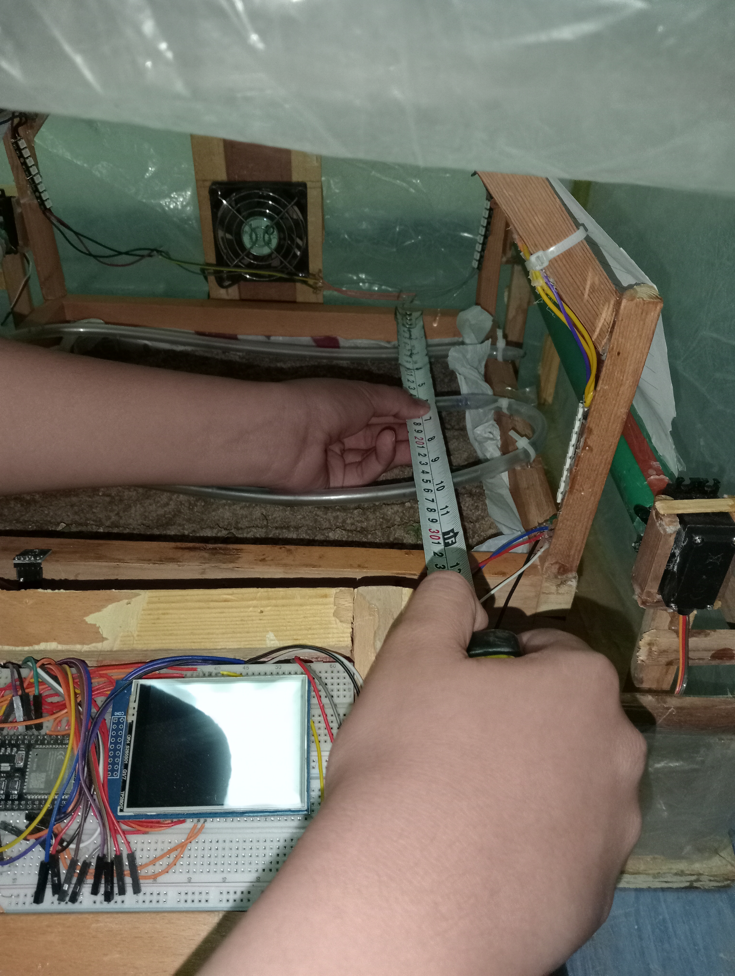
Docs/Build-photos/measuring length.jpg
