Yaseen301/eruca-sync-smart-greenhouse/Docs/Build-photos/measuring width.jpg

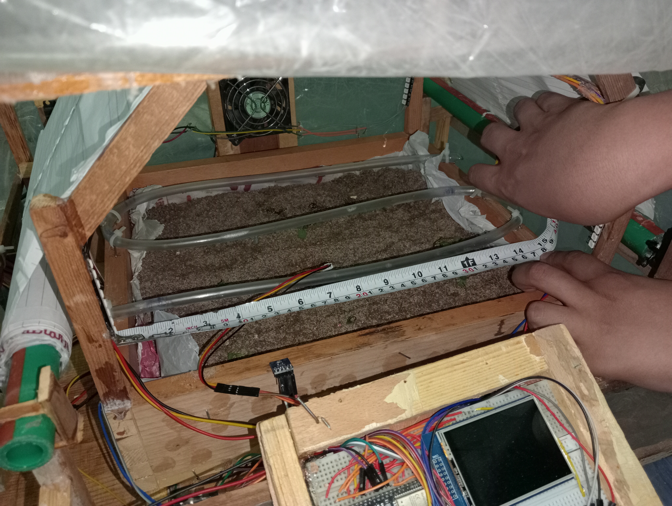
Docs/Build-photos/measuring width.jpg
