Yaseen301/eruca-sync-smart-greenhouse/Docs/Build-photos/neopixel_chain_soldering.png

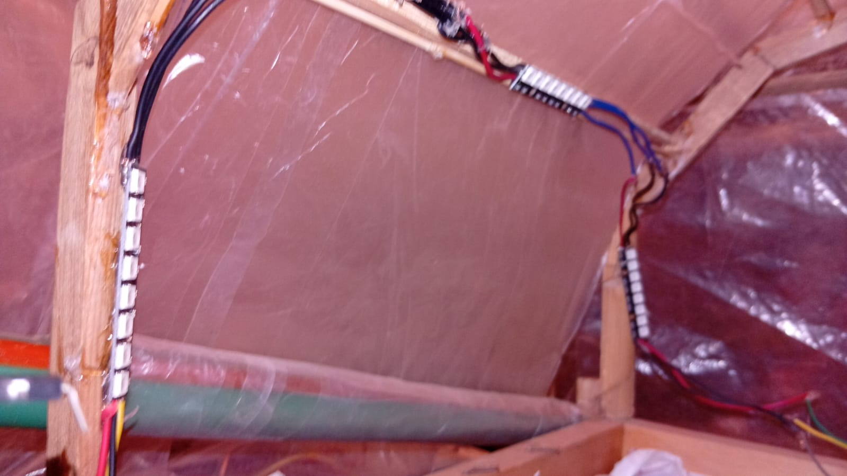
Docs/Build-photos/neopixel_chain_soldering.png
