Yaseen301/eruca-sync-smart-greenhouse/Docs/Build-photos/peltier_cooling_system_assembly.png

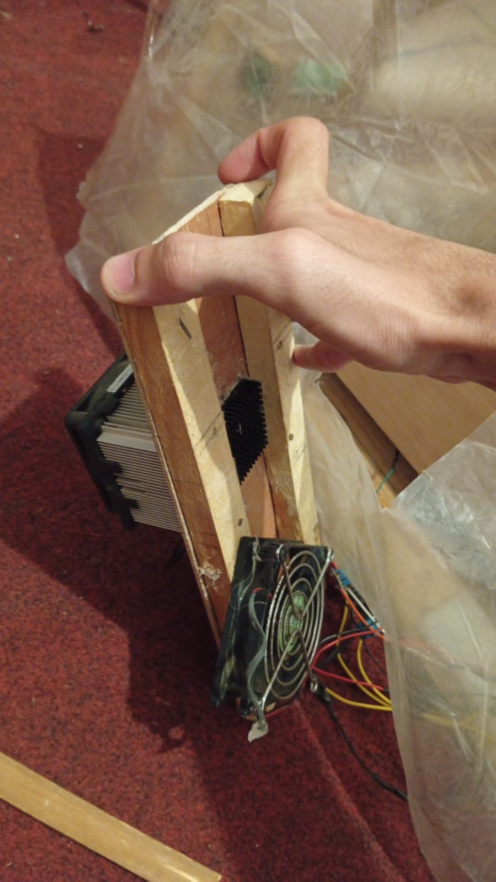
Docs/Build-photos/peltier_cooling_system_assembly.png
