Yaseen301/eruca-sync-smart-greenhouse/Docs/Build-photos/psu_voltage_rails.png

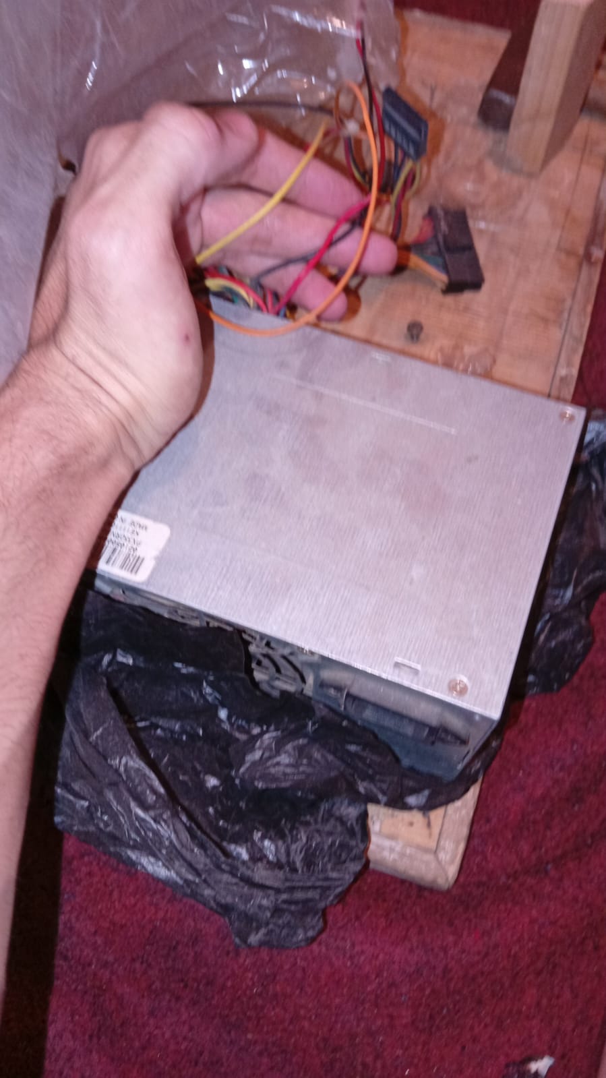
Docs/Build-photos/psu_voltage_rails.png
