Yaseen301/eruca-sync-smart-greenhouse/Docs/Build-photos/pvc_pipes_home.png

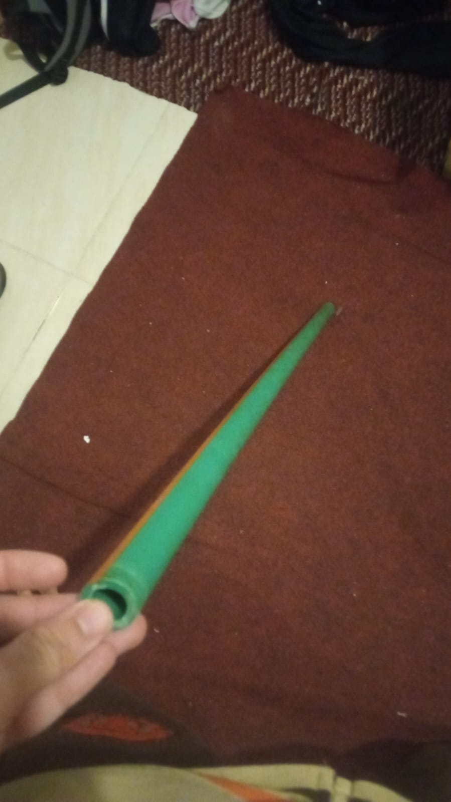
Docs/Build-photos/pvc_pipes_home.png
