Yaseen301/eruca-sync-smart-greenhouse/Docs/Build-photos/regular sand.jpg

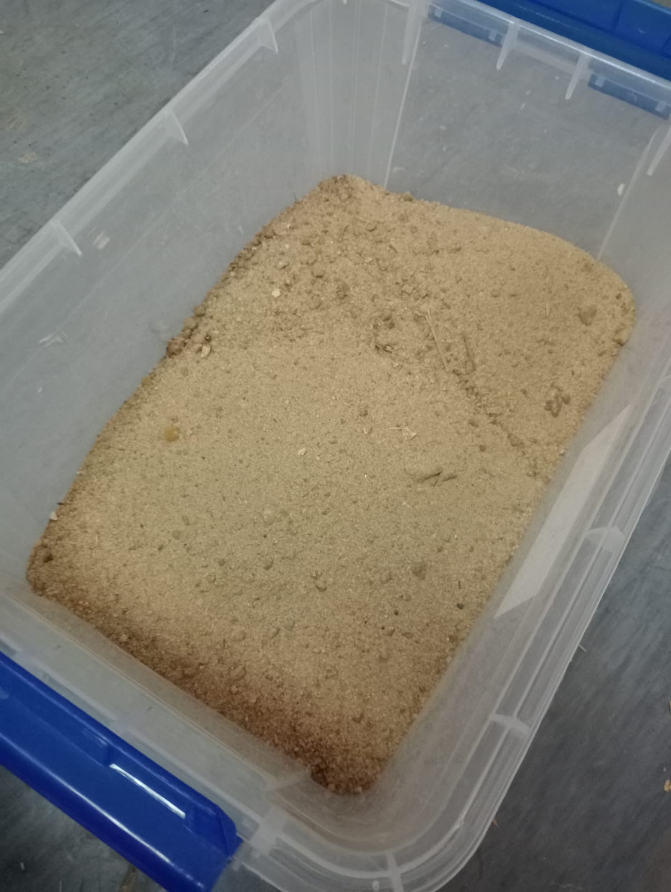
Docs/Build-photos/regular sand.jpg
