Yaseen301/eruca-sync-smart-greenhouse/Docs/Build-photos/school_backyard_wood.png

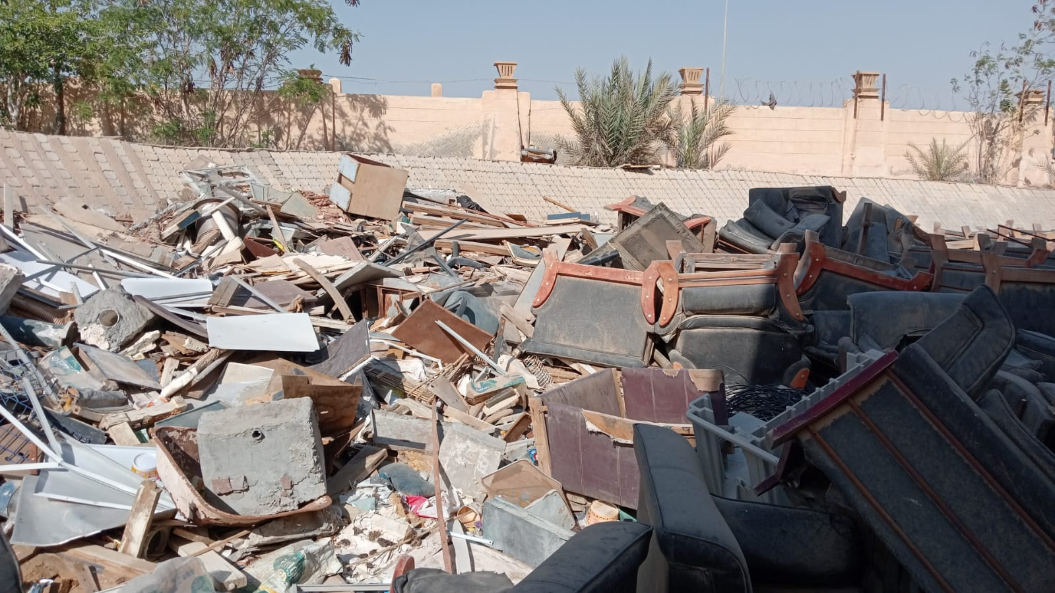
Docs/Build-photos/school_backyard_wood.png
