Yaseen301/eruca-sync-smart-greenhouse/Docs/Build-photos/servo_pvc_coupling.png

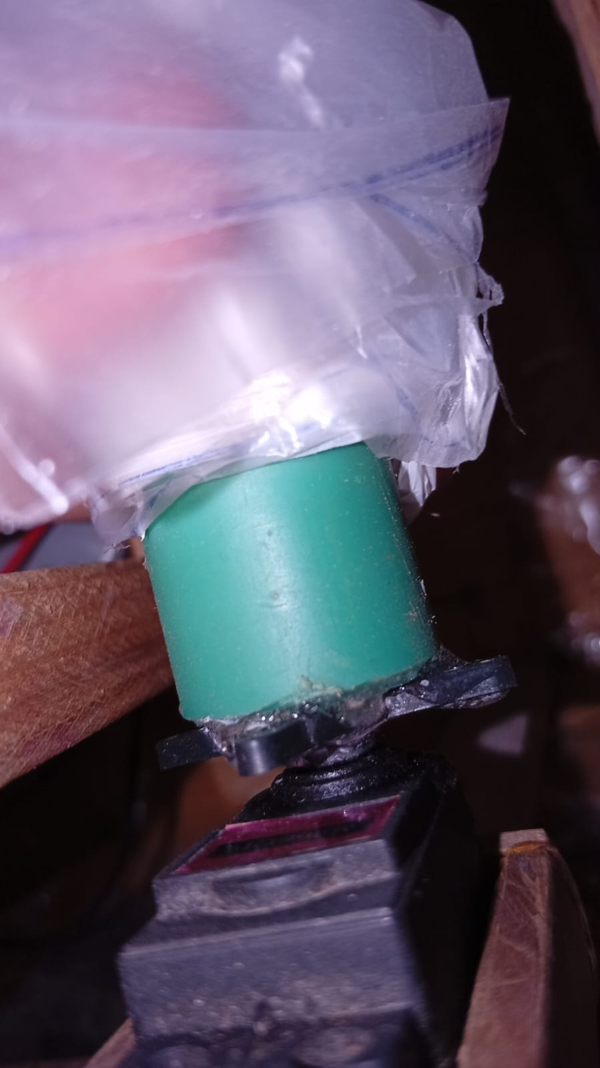
Docs/Build-photos/servo_pvc_coupling.png
