Yaseen301/eruca-sync-smart-greenhouse/Docs/Build-photos/soil_drawer_plastic_lining.png

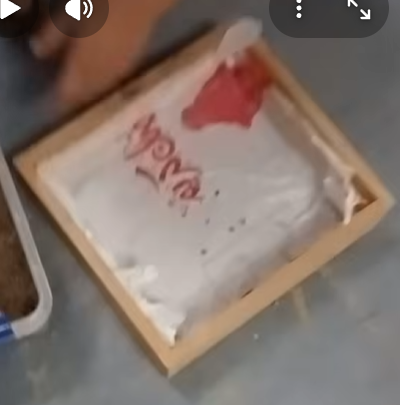
Docs/Build-photos/soil_drawer_plastic_lining.png
