Yaseen301/eruca-sync-smart-greenhouse/Docs/Build-photos/top_ventilation_windows.png

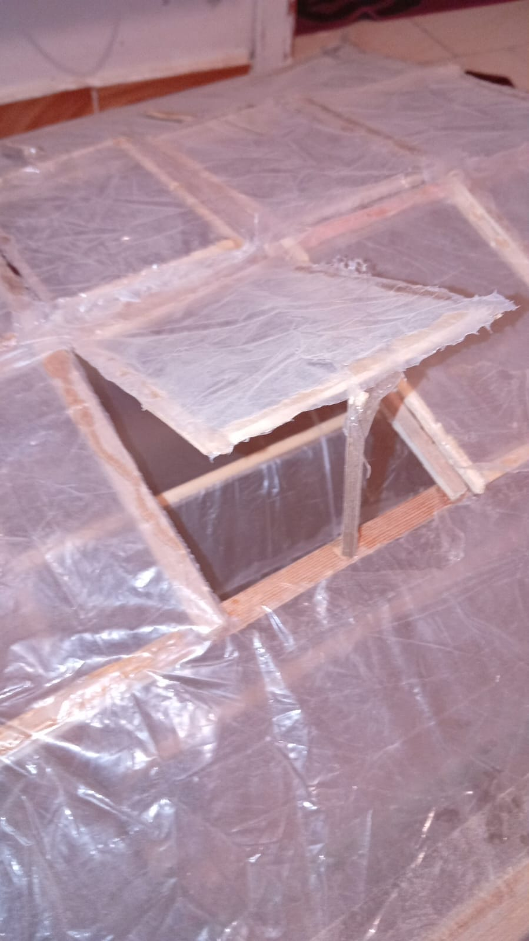
Docs/Build-photos/top_ventilation_windows.png
