Yaseen301/eruca-sync-smart-greenhouse/Docs/Build-photos/washing sand.jpg

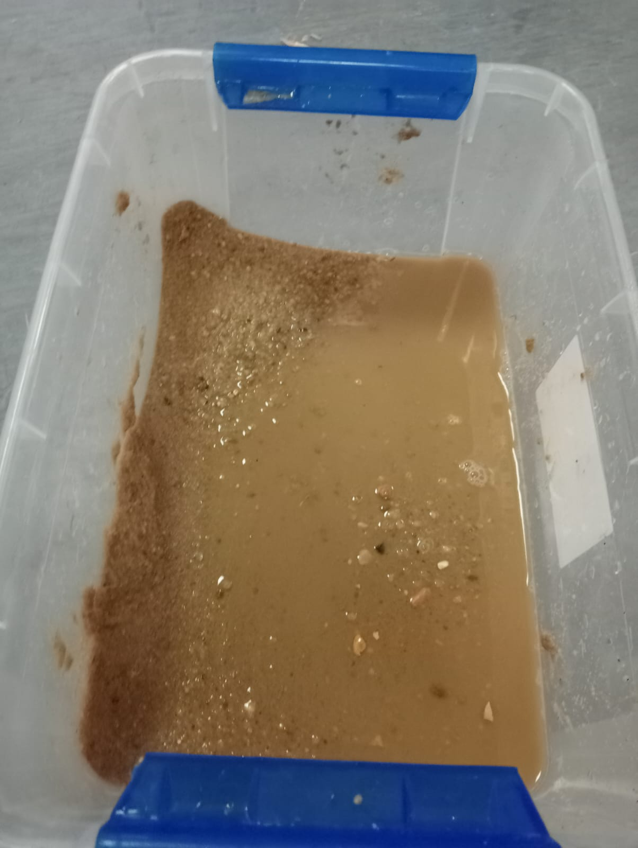
Docs/Build-photos/washing sand.jpg
