Yaseen301/eruca-sync-smart-greenhouse/Docs/Build-photos/wiring_harness_routing.png

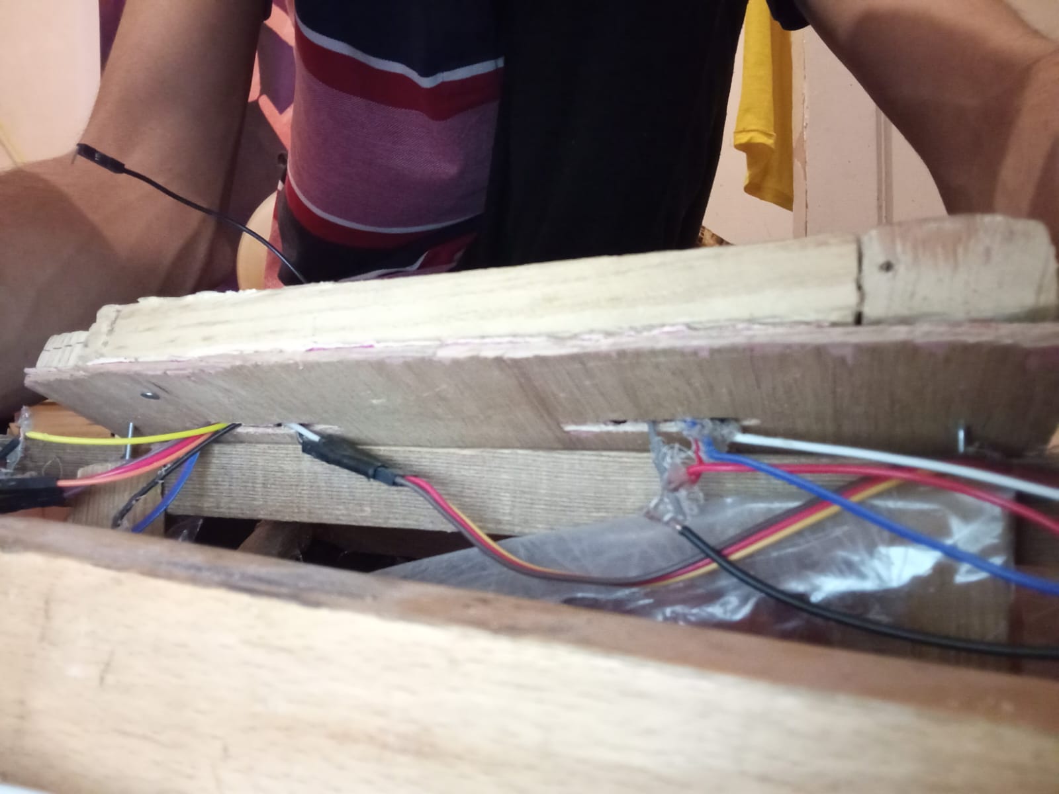
Docs/Build-photos/wiring_harness_routing.png
