Yaseen301/eruca-sync-smart-greenhouse/Docs/Build-photos/wooden_control_panel.png

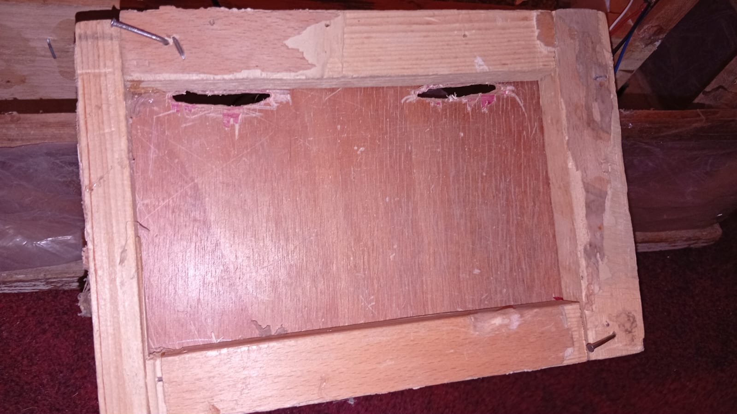
Docs/Build-photos/wooden_control_panel.png
