Yaseen301/eruca-sync-smart-greenhouse/Docs/Build-photos/wooden_smooth_arc.png

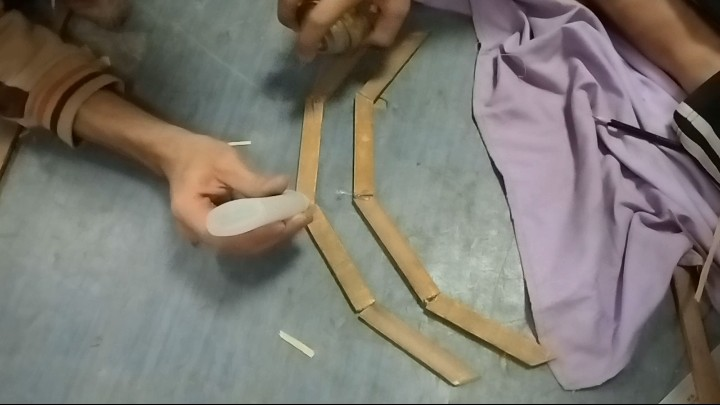
Docs/Build-photos/wooden_smooth_arc.png
