Yaseen301/eruca-sync-smart-greenhouse/Docs/fallout zine(Eruca-Sync).pdf

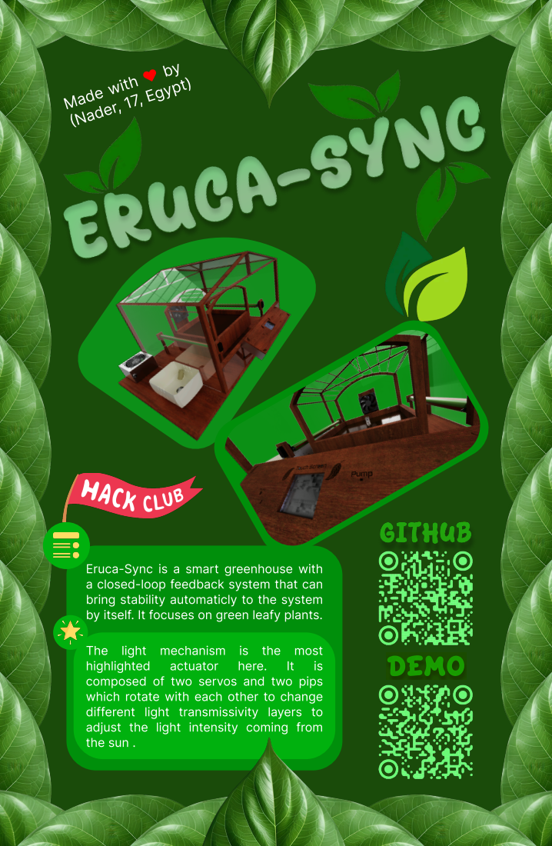
[picture p118: page 1]
(Nader, 17, Egypt); The; light mechanism; the; most; highlighted; actuator; here.

Made with ❤️ by

Eruca-Sync is a smart greenhouse with
a closed-loop feedback system that can
bring stability automaticly to the system
by itself. It focuses on green leafy plants.

composed of two servos and two pips
which rotate with each other to change
different light transmissivity layers to
adjust the light intensity coming from
the sun .
