Yaseen301/eruca-sync-smart-greenhouse/PCB/Cap S2.kicad_pcb

## KiCad design PCB/Cap S2.kicad_pcb (2026-10-24)

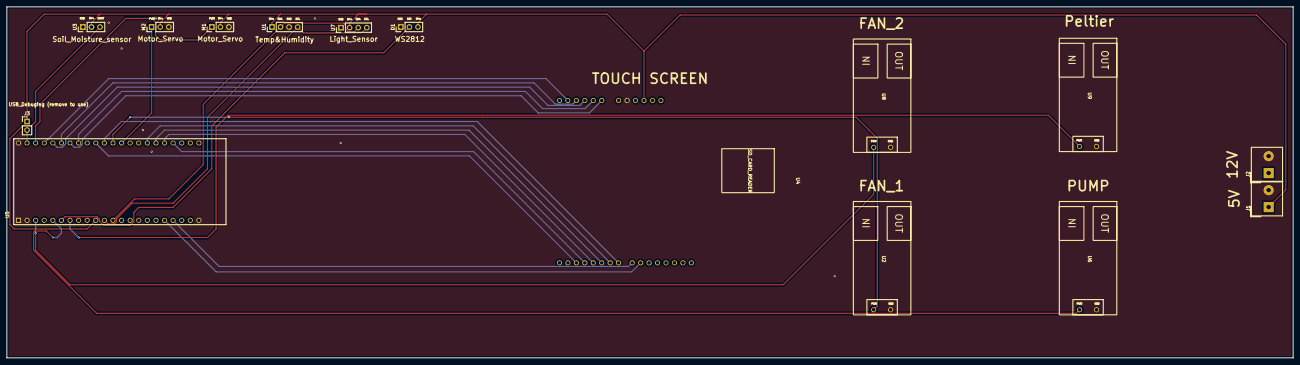
[picture p119: board Cap S2.kicad_pcb from above]

Board: 2 copper layers, 380.2 x 103.7 mm, 15 parts (0 on the bottom side), 27 nets.

Parts:
D1: WS2812; PinHeader_1x03_P2.54mm_Vertical
J1: 5v&GND; Altech_AK100_1x02_P5.00mm
J2: 12v&GND; Altech_AK100_1x02_P5.00mm
J3: USB_Debuging (remove to use); PinHeader_1x02_P2.54mm_Vertical
M1, M2: Motor_Servo; PinHeader_1x03_P2.54mm_Vertical
U1: Temp&Humidity; PinHeader_1x04_P2.54mm_Vertical
U2: Fan1; MOSFET_KIT
U3: Soil_Moisture_sensor; PinHeader_1x03_P2.54mm_Vertical
U4: TFT_ILI9341_arduino_Sheid; TFT_SCREEN
U5: ESP32-S3; ESP32-S3-DEVKITC-1
U6: Pump; MOSFET_KIT
U7: Light_Sensor; PinHeader_1x04_P2.54mm_Vertical
U8: Fan2; MOSFET_KIT
U9: Platier; MOSFET_KIT

Connections:
5v+: D1.3 (VCC), J1.1, J3.1, M1.2 (+), M2.2 (+), U1.1 (VDD), U3.2 (VCC), U4.10 (5V), U7.2 (VCC)
Fan1: U2.2 (PWM+), U5.33 (GPIO18)
Fan2: U5.3 (GPIO19/USB_D-), U8.2 (PWM+)
GND: D1.1 (VSS), J1.2, J2.2, M1.3 (-), M2.3 (-), U1.3 (GND), U2.1 (GND), U3.1 (GND), U4.8 (GND), U5.1 (GND), U5.2 (GND), U5.22 (GND), U5.44 (GND), U6.1 (GND), U7.1 (GND), U8.1 (GND), U9.1 (GND)
LCD0: U4.20 (LCD_D0), U5.19 (GPIO1)
LCD1: U4.19 (LCD_D1), U5.18 (GPIO2)
LCD2: U4.26 (LCD_D2), U5.35 (GPIO3)
LCD3: U4.25 (LCD_D3), U5.26 (GPIO4)
LCD4: U4.24 (LCD_D4), U5.27 (GPIO5)
LCD5: U4.23 (LCD_D5), U5.28 (GPIO6)
LCD6: U4.22 (LCD_D6), U5.29 (GPIO7)
LCD7: U4.21 (LCD_D7), U5.34 (GPIO8)
LCD_CS: U4.3 (LCD_CS), U5.39 (GPIO11)
LCD_RD: U4.6 (LCD_RD), U5.38 (GPIO10)
LCD_RS: U4.4 (LCD_RS), U5.40 (GPIO12)
LCD_RST: U4.2 (LCD_RST), U5.41 (GPIO13)
LCD_WR: U4.5 (LCD_WR), U5.37 (GPIO9)
Mois_Dout: U3.3 (AUOUT), U5.10 (GPIO35)
unnamed: J3.2, U5.43 (VDDA)
unnamed: U5.23 (VDD3P3), U5.24 (VDD3P3)
Platier: U5.7 (SPICLK_N), U9.2 (PWM+)
Pump: U5.5 (GPIO21), U6.2 (PWM+)
RGB: D1.2 (DIN), U5.6 (SPICLK_P)
SCL_light: U1.4 (SCL), U5.11 (GPIO36), U7.4 (SCL)
SDA_light: U1.2 (SDA), U5.12 (GPIO37), U7.3 (SDA)
Servo1: M1.1 (PWM), U5.42 (GPIO14)
Servo2: M2.1 (PWM), U5.32 (GPIO17)
