Yaseen301/eruca-sync-smart-greenhouse/(commit log)

2026-10-24 Add verified import of complete upstream Eruca Sync materials
2026-10-24 Import Eruca Sync firmware, CAD, PCB, and build materials with original credits
    [3D.step, BOM.csv, Cap S2.kicad_pcb, Cap S2.kicad_sch, Cap S2.step, ESP32-S3.kicad_sch, FInal_fabrication_bom.csv, FInal_fabrication_designators.csv]
